sxunxin/2024_Adventure_Design_Contest/README.md

# 2024 Adventure Design Contest 

이 프로젝트는 **2024 Adventure Design Contest**에 참가하여 **장려상**을 수상한 작품입니다.

## 개요
컵의 크기와 이미 담긴 물의 양을 자동으로 인식하여 적당량의 물을 채워주는 아두이노 기반의 정수기 시스템입니다.

회로 설계와 소스 코드 구현을 직접 담당하였습니다.

## 기술 스택
* c++
* Audino

## 파일 설명
- **AutomaticWaterDispenser.ino**: 아두이노 소스 코드
- **Contest_Report.pdf**: 대회 제출용 프로젝트 리포트
- **Award_Certificate.jpg**: 장려상 상장 이미지
