sxunxin/2024_Adventure_Design_Contest/Documents/Award_Certificate.JPG

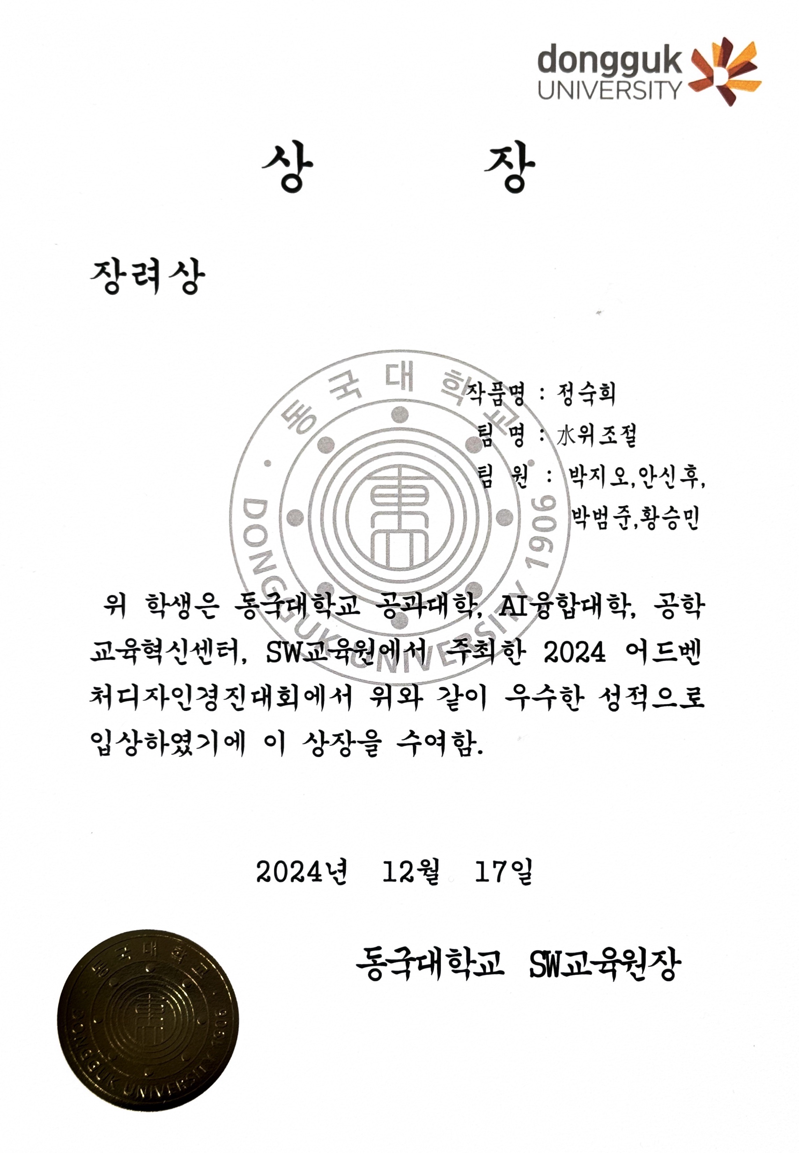
Documents/Award_Certificate.JPG
